macinmoss/xlite-firmware/peach_light/Disc_BT832X_fingers_v1/Disc_BT832X_fingers_v1.kicad_pcb

## KiCad design peach_light/Disc_BT832X_fingers_v1/Disc_BT832X_fingers_v1.kicad_pcb (2026-04-16)

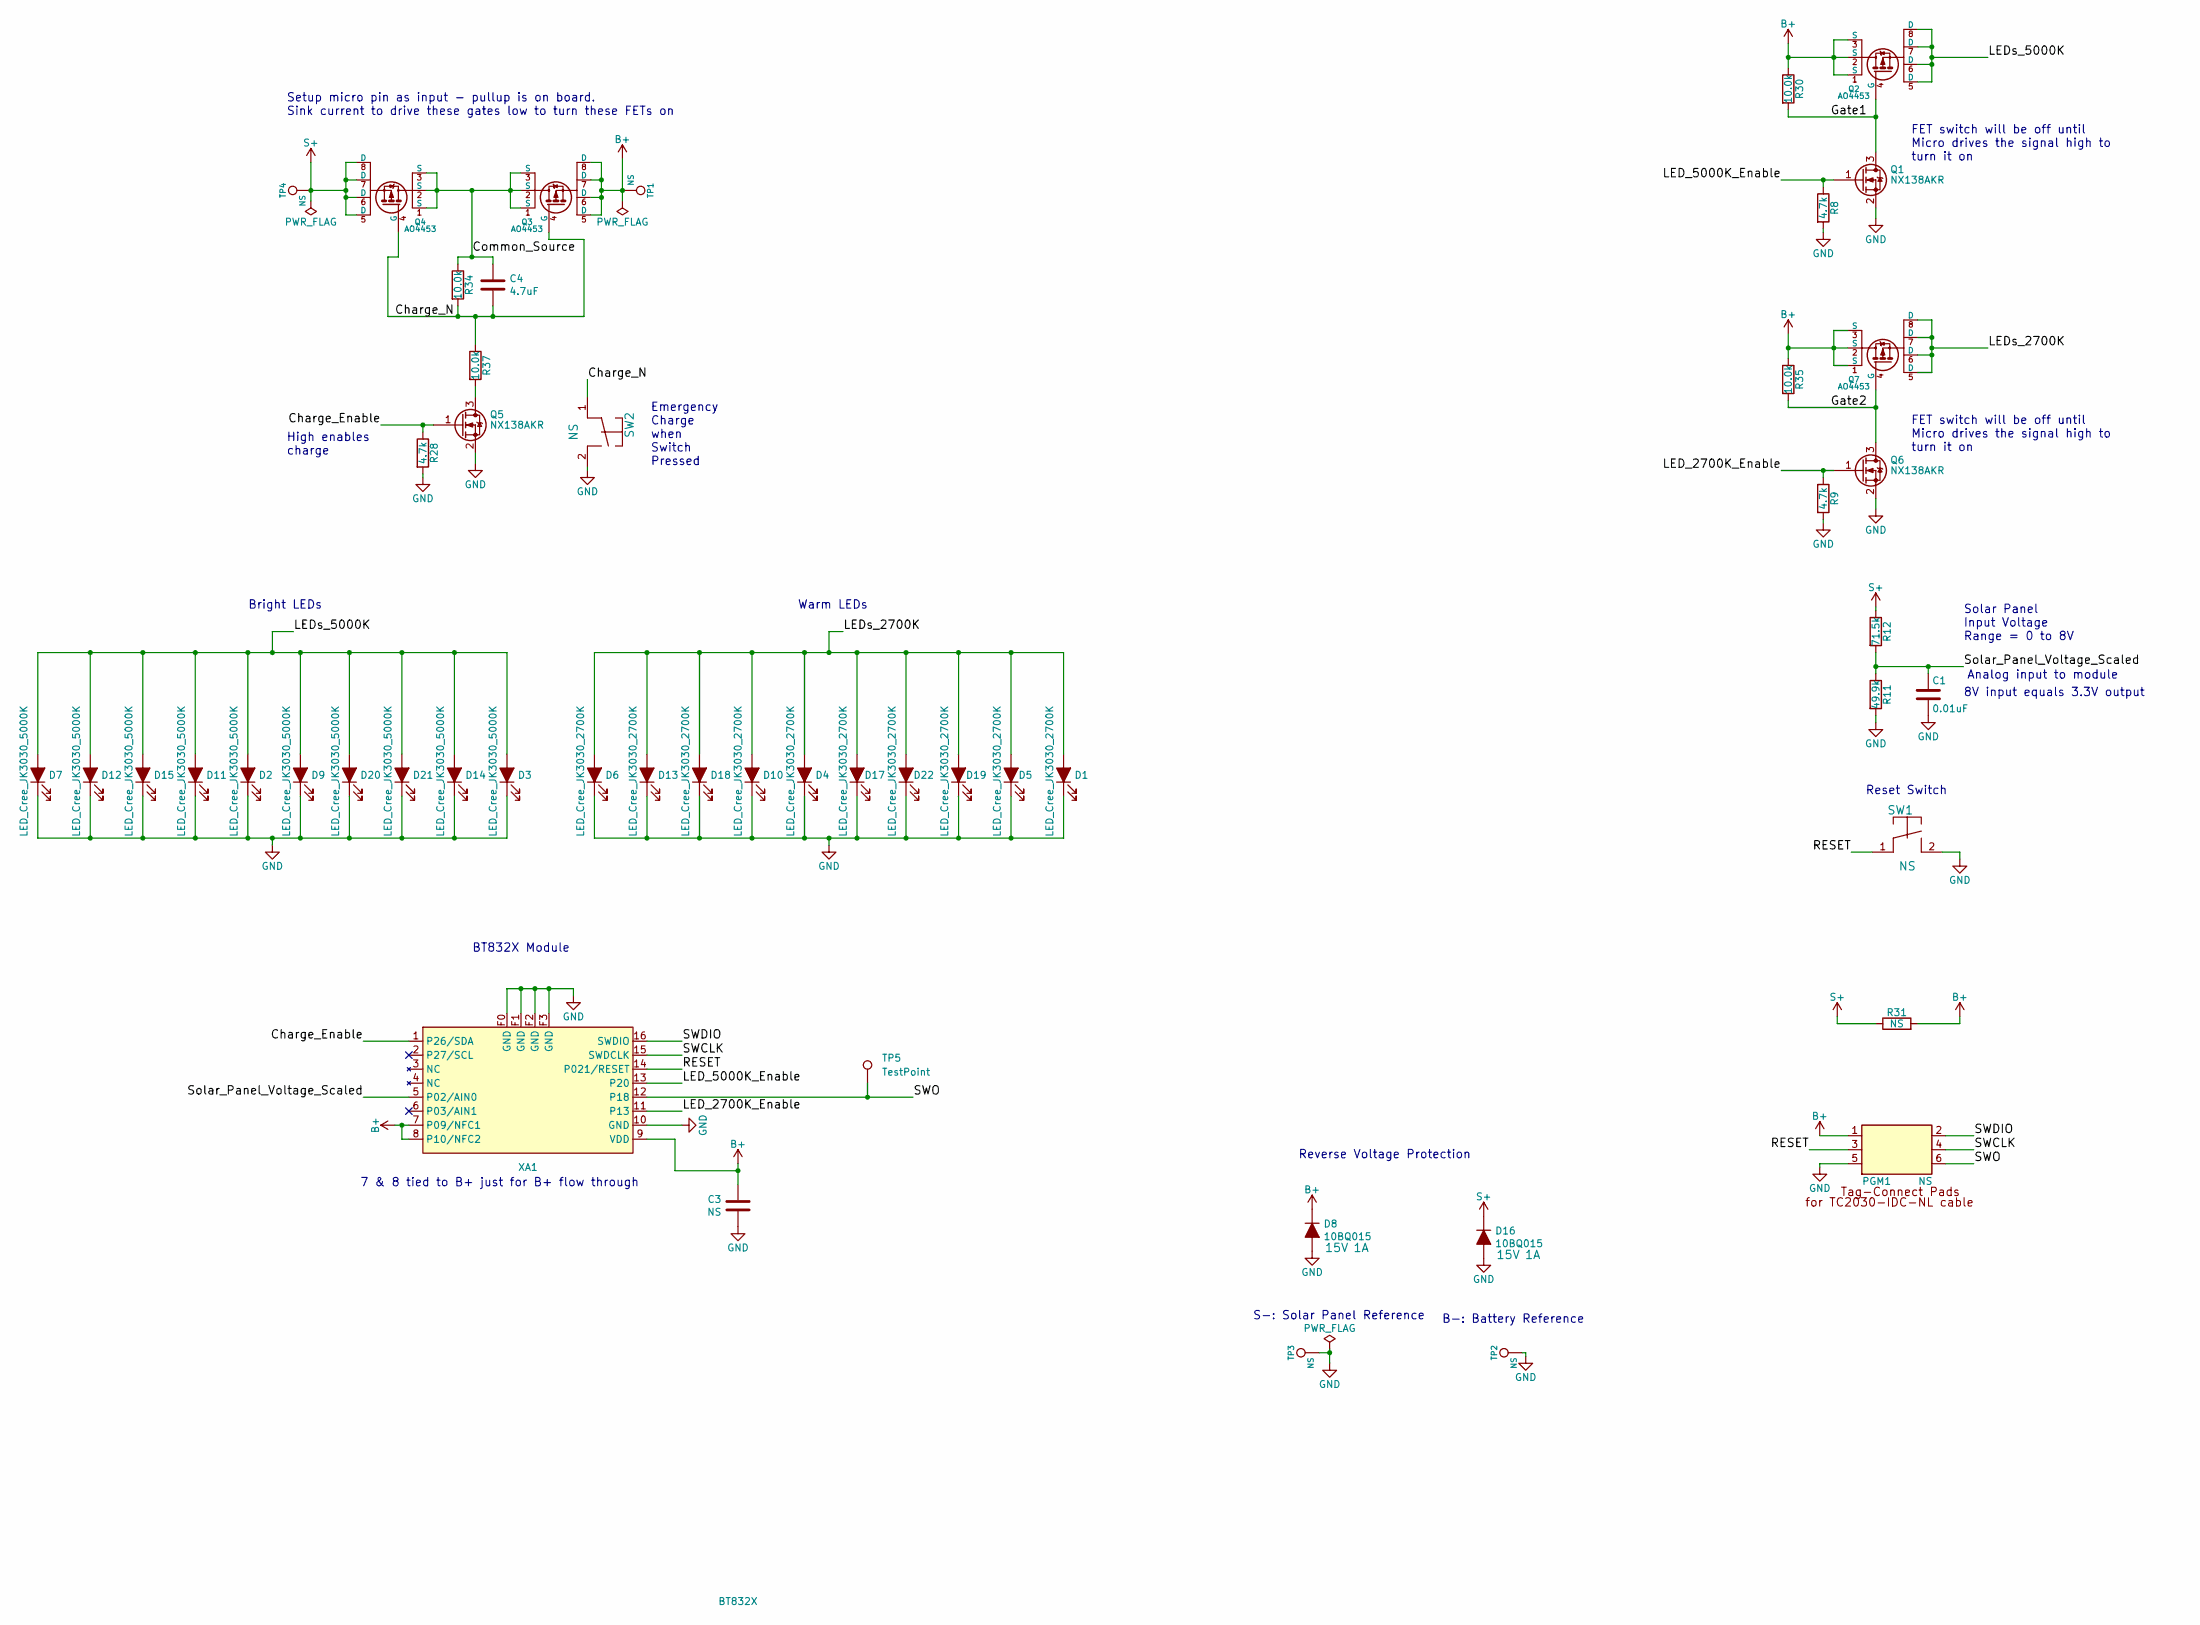
[picture p1: schematic Disc_BT832X_fingers_v1.kicad_sch, Project: Disc with BT832X Module]

Parts:
C1: 0.01uF; C_0603_1608Metric; MPN CGA3E2X7R1H103K080AA
C3: NS; C_1206_3216Metric
C4: 4.7uF; C_0805_2012Metric; MPN C2012X7R1A475M125AC
D1, D4, D5, D6, D10, D13, D17, D18, D19, D22: LED_Cree_JK3030_2700K; LED_Cree-J_Series_3030; MPN JK3030AWT-00-0000-000A0HL250E
D2, D3, D7, D9, D11, D12, D14, D15, D20, D21: LED_Cree_JK3030_5000K; LED_Cree-J_Series_3030; MPN JK3030AWT-00-0000-000A0HL250E
D8, D16: 10BQ015; D_SMB; Voltage 15V; MPN 10BQ015
PGM1: NS; PADS_PROGRAMMING_Tag-Connect_TC2030-IDC-NL; MPN None
Q1, Q5, Q6: NX138AKR; SOT-23; MPN NX138AKR
Q2, Q3, Q4, Q7: AO4453; Q_Vishay_Si4465ADY_SOIC-8_3.9x4.9mm_P1.27mm; MPN AO4453
R8, R9, R28: 4.7k; R_0603_1608Metric; MPN RC0603FR-074K7L
R11: 49.9k; R_0603_1608Metric; MPN ERJ-3EKF4992V
R12: 71.5k; R_0603_1608Metric; MPN ERJ-3EKF7152V
R30, R34, R35, R37: 10.0k; R_0603_1608Metric; MPN AC0603FR-0710KL
R31: NS; R_0603_1608Metric; MPN Not_Specified
SW1, SW2: NS; SW_SPST_Omron_B3U-1000P; MPN Not_Specified
TP1, TP2, TP3, TP4: NS; WirePad_2.5mmx2.5mm; MPN Not_Specified
TP5: TestPoint; TestPoint_Pad_04
XA1: BT832X; Fanstel_BT832X_without_BGA

Connections:
/Charge_Enable: Q5.1 (G), R28.1, XA1.1 (P26/SDA)
/Charge_N: C4.2, Q3.4 (G), Q4.4 (G), R34.2, R37.1, SW2.1
/Common_Source: C4.1, Q3.1 (S), Q3.2 (S), Q3.3 (S), Q4.1 (S), Q4.2 (S), Q4.3 (S), R34.1
/Gate1: Q1.3 (D), Q2.4 (G), R30.2
/Gate2: Q6.3 (D), Q7.4 (G), R35.2
/LED_2700K_Enable: Q6.1 (G), R9.1, XA1.11 (P13)
/LED_5000K_Enable: Q1.1 (G), R8.1, XA1.13 (P20)
/LEDs_2700K: D1.2 (A), D4.2 (A), D5.2 (A), D6.2 (A), D10.2 (A), D13.2 (A), D17.2 (A), D18.2 (A), D19.2 (A), D22.2 (A), Q7.5 (D), Q7.6 (D), Q7.7 (D), Q7.8 (D)
/LEDs_5000K: D2.2 (A), D3.2 (A), D7.2 (A), D9.2 (A), D11.2 (A), D12.2 (A), D14.2 (A), D15.2 (A), D20.2 (A), D21.2 (A), Q2.5 (D), Q2.6 (D), Q2.7 (D), Q2.8 (D)
/RESET: PGM1.3, SW1.1, XA1.14 (P021/RESET)
/SWCLK: PGM1.4, XA1.15 (SWDCLK)
/SWDIO: PGM1.2, XA1.16 (SWDIO)
/SWO: PGM1.6, TP5.1, XA1.12 (P18)
/Solar_Panel_Voltage_Scaled: C1.1, R11.1, R12.2, XA1.5 (P02/AIN0)
B+: C3.1, D8.1 (K), PGM1.1, Q2.1 (S), Q2.2 (S), Q2.3 (S), Q3.5 (D), Q3.6 (D), Q3.7 (D), Q3.8 (D), Q7.1 (S), Q7.2 (S), Q7.3 (S), R30.1, R31.2, R35.1, TP1.1, XA1.7 (P09/NFC1), XA1.8 (P10/NFC2), XA1.9 (VDD)
GND: C1.2, C3.2, D1.1 (K), D2.1 (K), D3.1 (K), D4.1 (K), D5.1 (K), D6.1 (K), D7.1 (K), D8.2 (A), D9.1 (K), D10.1 (K), D11.1 (K), D12.1 (K), D13.1 (K), D14.1 (K), D15.1 (K), D16.2 (A), D17.1 (K), D18.1 (K), D19.1 (K), D20.1 (K), D21.1 (K), D22.1 (K), PGM1.5, Q1.2 (S), Q5.2 (S), Q6.2 (S), R8.2, R9.2, R11.2, R28.2, SW1.2, SW2.2, TP2.1, TP3.1, XA1.10 (GND), XA1.F0 (GND), XA1.F1 (GND), XA1.F2 (GND), XA1.F3 (GND)
unnamed: Q5.3 (D), R37.2
S+: D16.1 (K), Q4.5 (D), Q4.6 (D), Q4.7 (D), Q4.8 (D), R12.1, R31.1, TP4.1

Notes on the sheet:
8V input equals 3.3V output
High enables charge
Bright LEDs
Setup micro pin as input - pullup is on board. Sink current to drive these gates low to turn these FETs on
Warm LEDs
7 & 8 tied to B+ just for B+ flow through
Solar Panel Input Voltage Range = 0 to 8V
Analog input to module
S-: Solar Panel Reference
BT832X Module
Reset Switch
B-: Battery Reference
FET switch will be off until Micro drives the signal high to turn it on
Emergency Charge when Switch Pressed
Reverse Voltage Protection

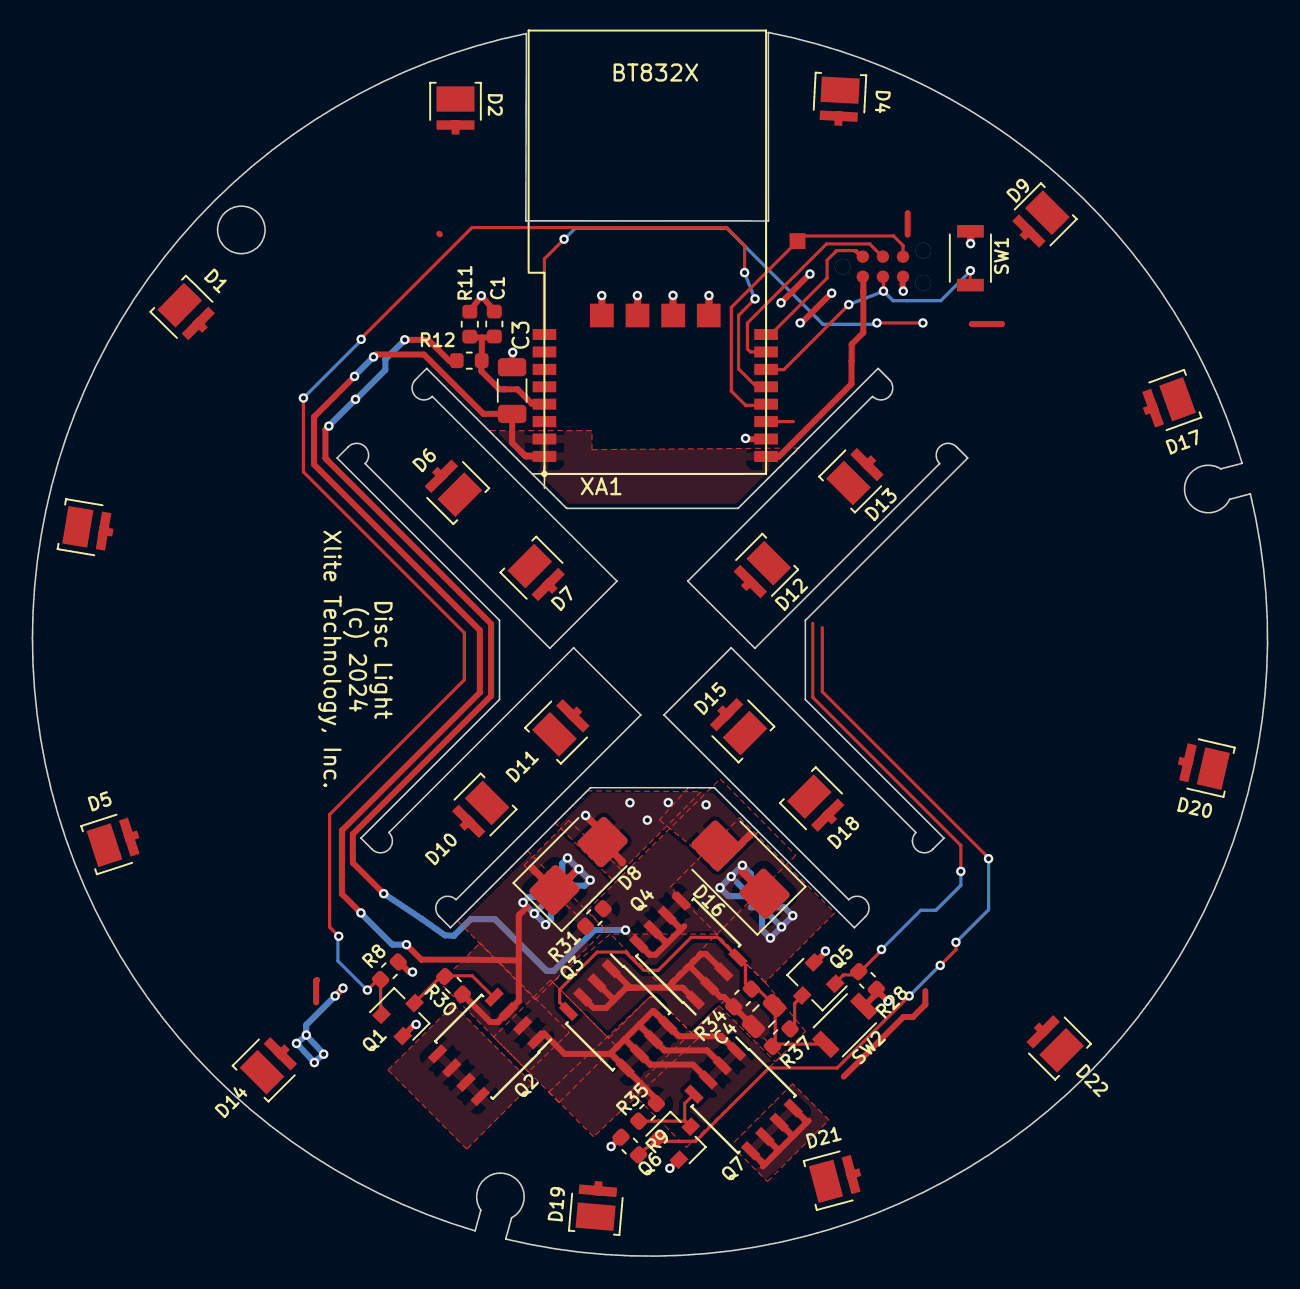
[picture p2: board Disc_BT832X_fingers_v1.kicad_pcb from above]

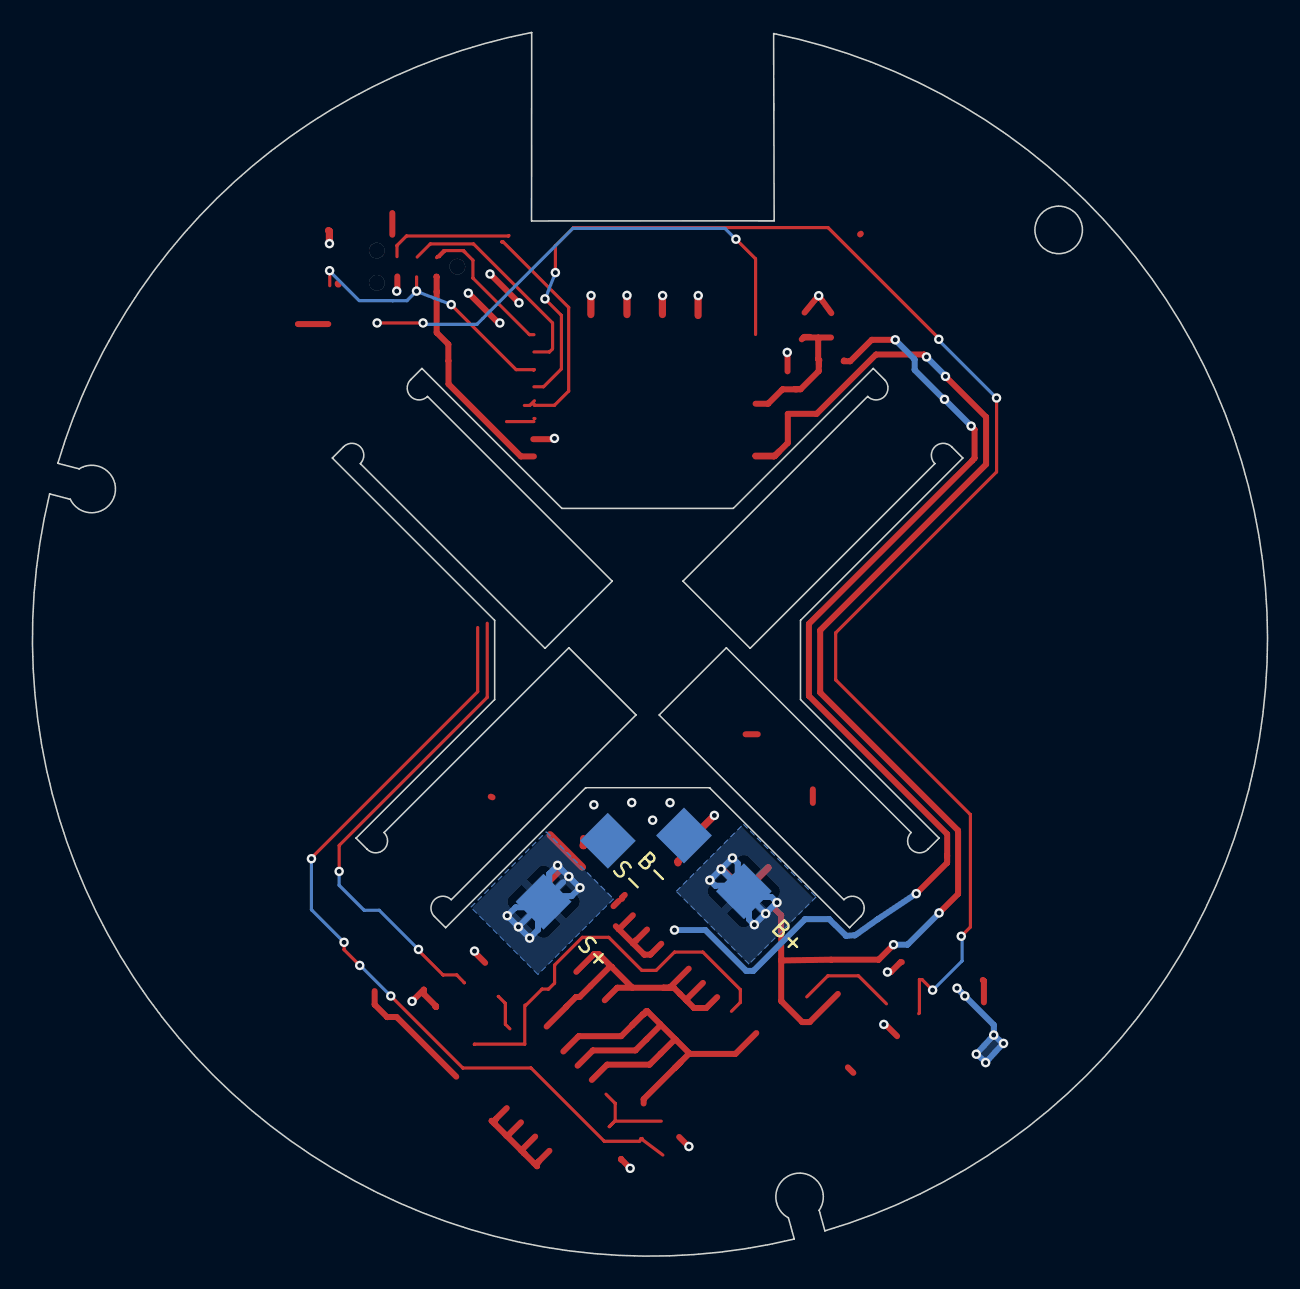
[picture p3: board Disc_BT832X_fingers_v1.kicad_pcb from below]

Board: 2 copper layers, 78.0 x 77.3 mm, 51 parts (4 on the bottom side), 18 nets.
