macinmoss/xlite-firmware/(notices)

Notices in the files:
peach_light/Disc_BT832X_fingers_v1/Disc_BT832X_fingers_v1.kicad_pcb:
(c) 2024
